mentist/markstim/Wiring/1) Breadboard.png

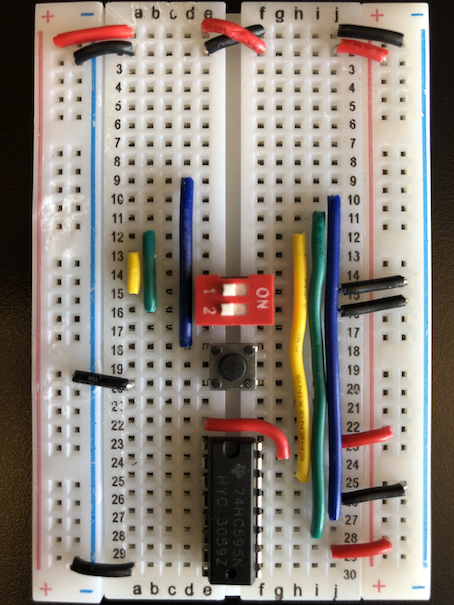
Wiring/1) Breadboard.png
