mentist/markstim/Wiring/2) Breadboard+Teensy.png

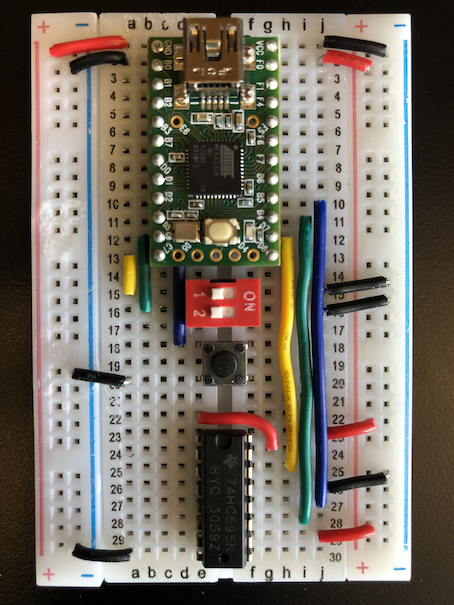
Wiring/2) Breadboard+Teensy.png
