mentist/markstim/Wiring/3) BNC male to jumper wire.png

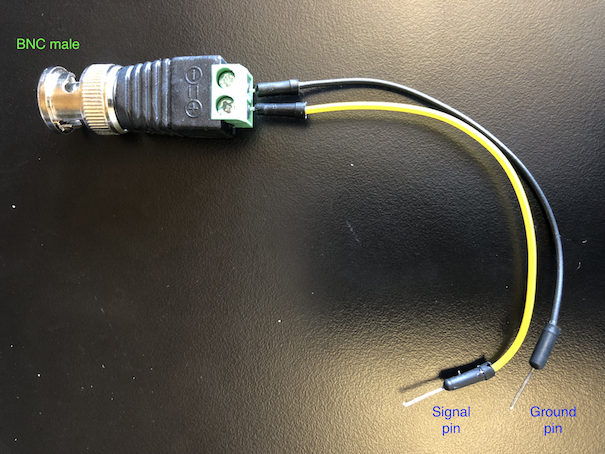
Wiring/3) BNC male to jumper wire.png
