mentist/markstim/Wiring/4) DB-25 to 9-pin male Dupont (inside).png

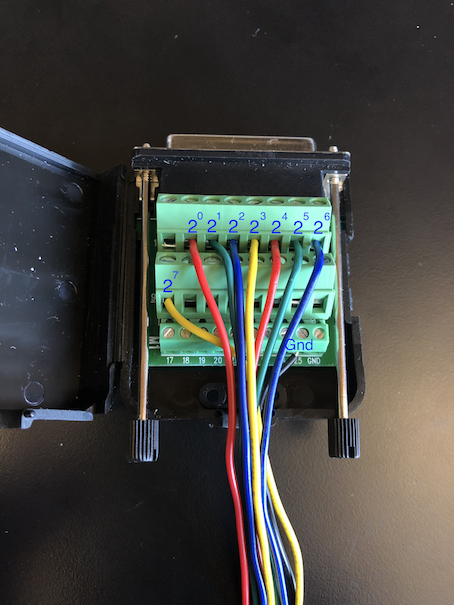
Wiring/4) DB-25 to 9-pin male Dupont (inside).png
