mentist/markstim/Wiring/5) DB-25 to 9-pin male Dupont (outside).png

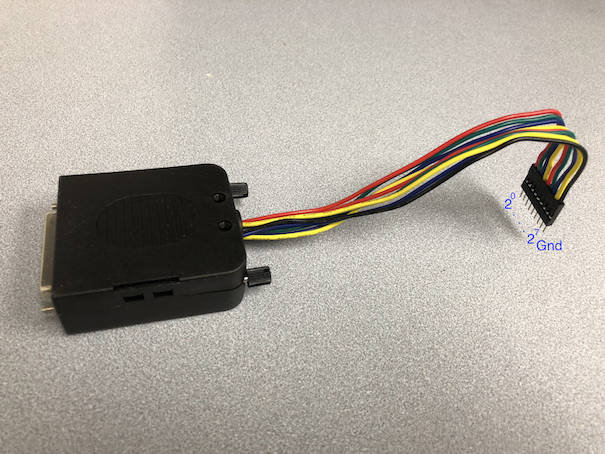
Wiring/5) DB-25 to 9-pin male Dupont (outside).png
