mentist/markstim/Wiring/6) The MarkStim device.png

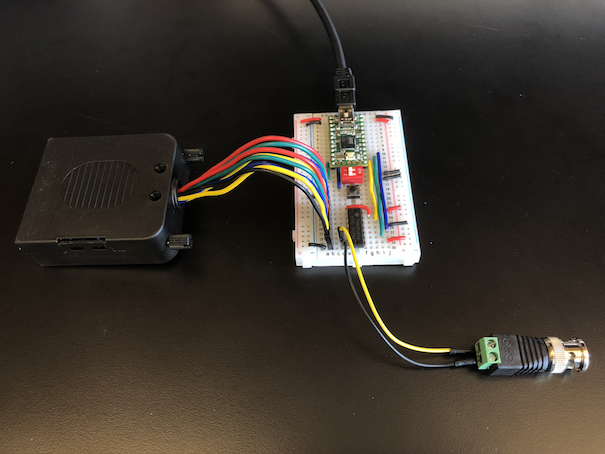
Wiring/6) The MarkStim device.png
