mentist/markstim/(commit log)

2019-05-28 Teensy LED test
2019-05-28 Button test through LED
2019-05-28 Branch for communication protocol only. Controlled LED by serial communication.
2019-05-28 Reduced the test case to character echoing.
2019-05-28 Made the extra button a reset button because Teensy's button is not for reset. Implemented software reset function for Teensy. Examined the switch states and stored these in program variables.
    [MarkStim.ino]
2019-05-28 Wrote and put LED feedback code inside DEBUGGING mode.
2019-05-29 Added wiring photos.
2019-07-08 Fixed a bug in if statement.
    [MarkStim.ino]
2020-03-10 Fixed Linux problem of dropping \r in feedback string. Wrote a Python wrapper class MarkStim().
    [Benchmark.py, MarkStim.c, MarkStim.ino, MarkStim.py]
